hectorBrown/graphite-sensor/obsidian/graphite-sensor/circuits/attachments/Pasted image 20260402162007.png

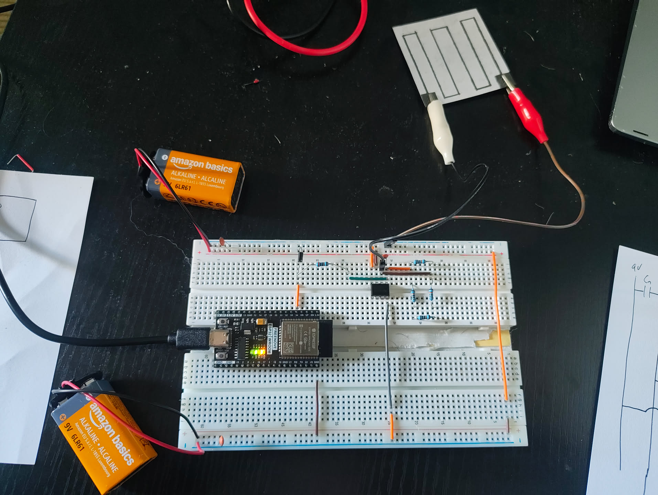
obsidian/graphite-sensor/circuits/attachments/Pasted image 20260402162007.png
