hectorBrown/graphite-sensor/obsidian/graphite-sensor/readings.md

| File name | Sensor | Circuit | Time step | Time measurement | Serial mode | Laptop power (if applicable) | Sensor motion |
| --- | --- | --- | --- | --- | --- | --- | --- |
| `sensor1-idle_1.txt` | [[sensors/v1\|v1]] | [[circuits/v1\|v1]] | 10ms | Delay | Physical | AC | Idle |
| `sensor2-idle_2.txt` | [[sensors/v1\|v1]] | [[circuits/v1\|v1]] | 5ms | Delay | Physical | AC | Idle |
| `sensor2-idle_3.txt` | [[sensors/v1\|v1]] | [[circuits/v1\|v1]] | 5ms | Delay | Physical | DC | Idle |
| `sensor1-idle_4.txt` | [[sensors/v1\|v1]] | [[circuits/v1\|v1]] | 5ms | RTC | Physical | DC | Idle |
| `sensor1-outward-90_1.txt` | [[sensors/v1\|v1]] | [[circuits/v1\|v1]] | 5ms | RTC | Physical | DC | Outward 90 degree bend |
