hectorBrown/graphite-sensor/obsidian/graphite-sensor/notes/2026-04-03.md

Sensor: [[sensors/v1|v1]]
Circuit: [[circuits/v1|v1]]

Worked out yesterday that because arduino code was measuring only the delay, frequencies were shifted up -- not measuring the time it takes to run the reading, switched to esp32 RTC for accurate time -- hasn't changed much though, not sure why we don't measure exactly 50Hz -- not really relevant as the noise is obviously that source and we don't worry about AC signals, maybe the frequency really is actually being stepped up or down by the capacitance in the circuit

[[sensor1-idle_4.txt]]
![[dc-power-spectrum.png]]
This still shows spike at ~51Hz on DC power, but an order of magnitude smaller... 
Std deviation at idle is now 10.58 - significant improvement -- real gains will come when buck converter arrives and i can move to serial over Bluetooth

[[sensor1-idle_4.txt]]
New idle histogram:
![[sensor1-idle-hist_dc.png]]

I measured an outward bend to approx 90 degrees:
[[sensor1-outward-90_1.txt]]
![[sensor1-outwardbend-timeseries.png]]
And fitted a cubic spline to it that I felt more or less represented the smooth motion of the sensor -- on vibes

The power spectrum for noise when this spline is subtracted from the time series is:
[[sensor1-outward-90_1.txt]]
![[outwardbend-power-spectrum.png]]
Where we can see that still, our primary source of noise is that 50Hz buzz -- at 1e8 now for reasons  I can't understand -- even with the laptop on DC power -- I wonder if the serial cable is acting as an antenna

Also want to make this kind of bending more predictable -- I don't mind fitting curves but certainly it would be better to be able to bend without actually touching the surface of the sensor -- thinking about a cantilever setup as in [this paper](https://www.researchgate.net/publication/229017122_Flexible_Graphite-on-Paper_Piezoresistive_Sensors) and a clamp to hold one end still
