hectorBrown/graphite-sensor/obsidian/graphite-sensor/circuits/v1.md

![[Pasted image 20260402161429.png]]
The setup is a trans-impedance amplifier monitoring a negative current through the sensor from its inverting input to the -9V rail.

| Component | Value |
| --- | --- |
| $C_n$ | 100nF |
| $R_f$ | 75k$\Omega$ |
| $C_f$ | 22pF |
| $R_p$ | 2k$\Omega$  |

The 75k$\Omega$ resistor is built from 100k$\Omega$ resistors like so:
![[Pasted image 20260402161343.png]]
![[Pasted image 20260402162007.png]]
