hectorBrown/graphite-sensor/obsidian/graphite-sensor/readings/readings.md

```dataview
TABLE sensor, circuit, time-step, time-measurement, laptop-power, sensor-motion
FROM #readings
```
