hectorBrown/graphite-sensor/obsidian/graphite-sensor/readings/files/sensor1-idle_1.txt.md

---
Sensor: "[[sensors/v1|v1]]"
Circuit: "[[circuits/v1|v1]]"
Time step: 10ms
Time measurement: Delay
Serial mode: Physical
Laptop power: AC
Sensor motion: Idle
tags:
  - readings
---
