hectorBrown/graphite-sensor/obsidian/graphite-sensor/readings/files/sensor1-idle_4.txt.md

---
Sensor: "[[sensors/v1|v1]]"
Circuit: "[[circuits/v1|v1]]"
Time step: 5ms
Time measurement: RTC
Serial mode: Physical
Laptop power: DC
Sensor motion: Idle
tags:
  - readings
---
