hectorBrown/graphite-sensor/obsidian/graphite-sensor/circuits/attachments/Pasted image 20260402161429.png

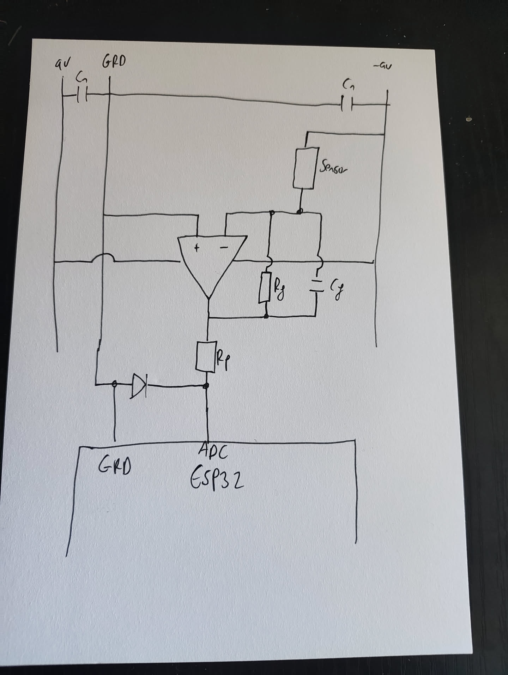
obsidian/graphite-sensor/circuits/attachments/Pasted image 20260402161429.png
