hectorBrown/graphite-sensor/obsidian/graphite-sensor/figures/dc-power-spectrum.png

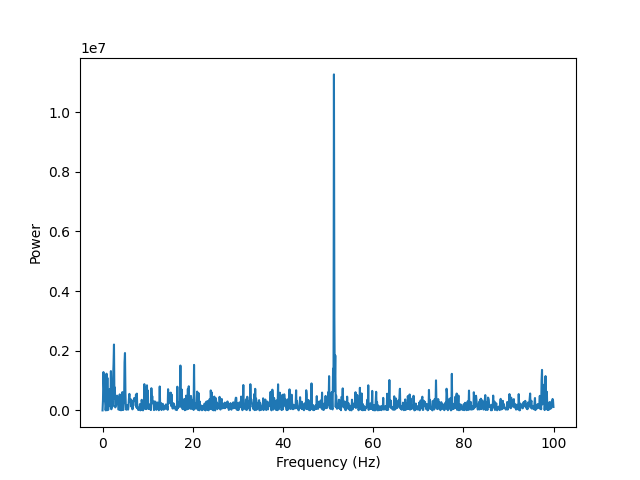
obsidian/graphite-sensor/figures/dc-power-spectrum.png
