hectorBrown/graphite-sensor/obsidian/graphite-sensor/figures/laptop-groundloop-demo.png

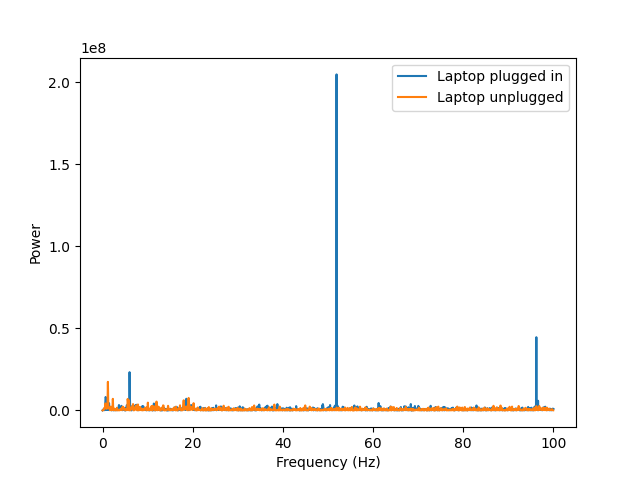
obsidian/graphite-sensor/figures/laptop-groundloop-demo.png
