hectorBrown/graphite-sensor/obsidian/graphite-sensor/figures/outwardbend-power-spectrum.png

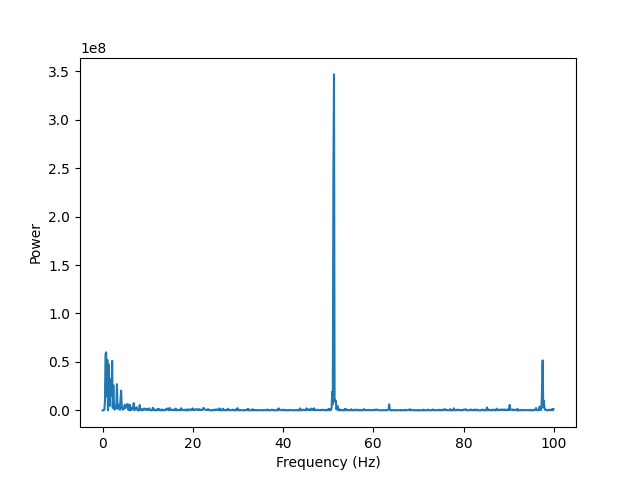
obsidian/graphite-sensor/figures/outwardbend-power-spectrum.png
