hectorBrown/graphite-sensor/obsidian/graphite-sensor/figures/sensor1-idle-hist.png

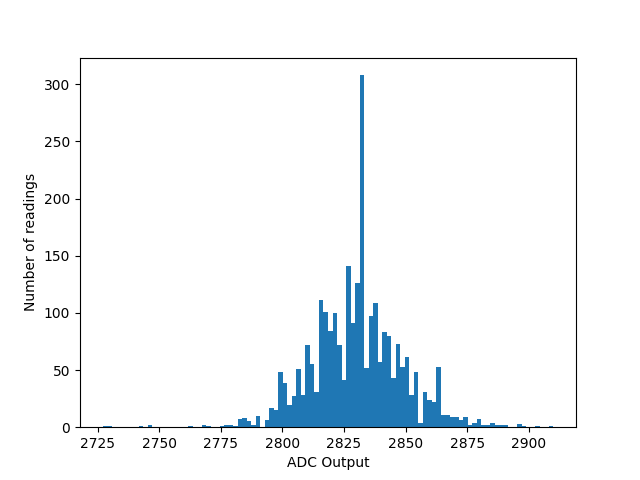
obsidian/graphite-sensor/figures/sensor1-idle-hist.png
