hectorBrown/graphite-sensor/obsidian/graphite-sensor/figures/sensor1-idle-hist_dc.png

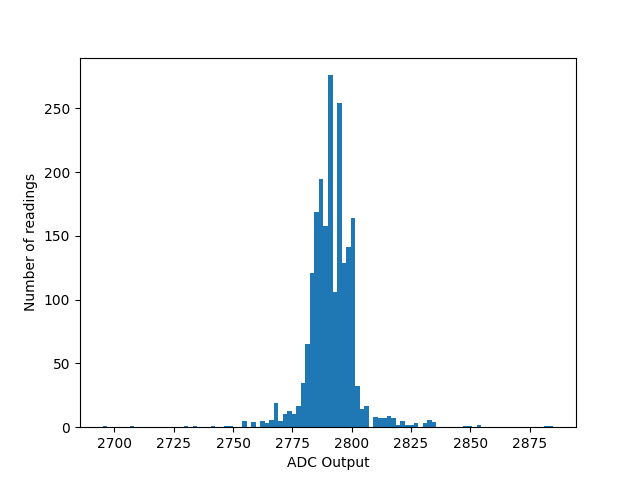
obsidian/graphite-sensor/figures/sensor1-idle-hist_dc.png
