hectorBrown/graphite-sensor/obsidian/graphite-sensor/figures/sensor1-outwardbend-timeseries.png

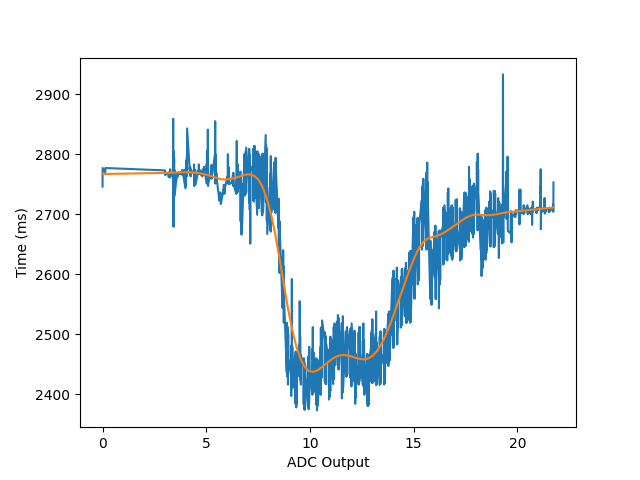
obsidian/graphite-sensor/figures/sensor1-outwardbend-timeseries.png
