hectorBrown/graphite-sensor/obsidian/graphite-sensor/pinouts/opamp.png

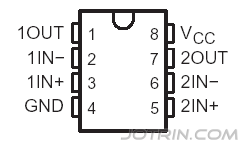
obsidian/graphite-sensor/pinouts/opamp.png
