hectorBrown/graphite-sensor/obsidian/graphite-sensor/sensors/attachments/Pasted image 20260330181508.png

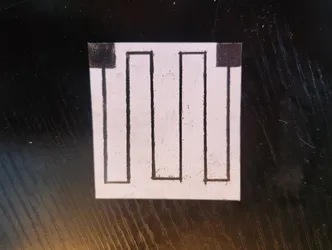
obsidian/graphite-sensor/sensors/attachments/Pasted image 20260330181508.png
